Monkgogi/3rd-year-project/FINAL PROJECT.pdf

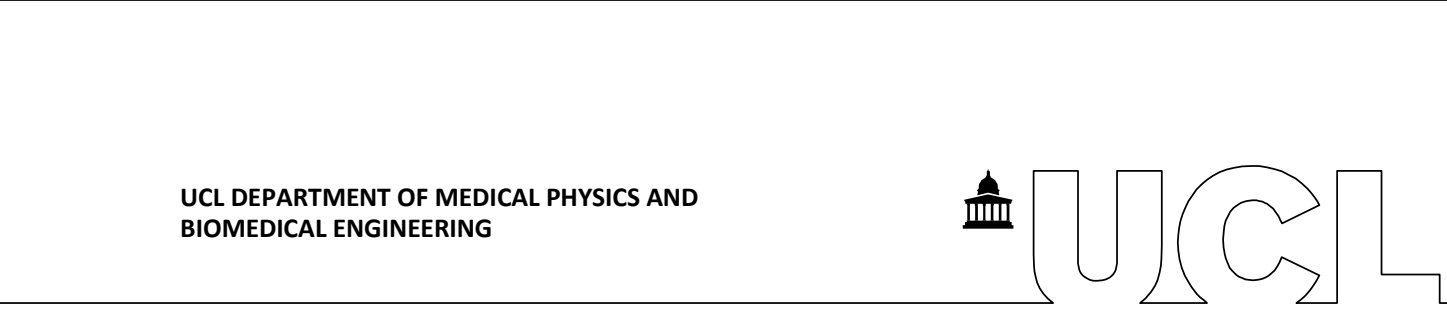
[picture p1: figure]
UCL DEPARTMENT OF MEDICAL PHYSICS AND BIOMEDICAL ENGINEERING

## Undergraduate Project Tracking Sheet

Module Code: | MPHY0042
Module Title : | Medical Physics and Biomedical Engineering Research Project
Coursework Title : | Final Report
First Supervisor | NADIPI REDDY, PRABHAV | 1 st supervisor’s e-mail | p.reddy@ucl.ac.uk
Second Supervisor | | 2 nd supervisors e-mail
Student’s Name: | Monkgogi Pako Galeitsiwe
Student’s e-mail address: | zcemmpg@ucl.ac.uk
1) Hand in a hardcopy to the main Reception Office (2nd Floor, MPEB).
Coursework Deadline: | 26 April 2021
| For Office Use Only

Date Received:

Date Returned to Student:

Before completing and submitting this piece of coursework please check that you are fully aware of the MPBE policy on plagiarism (See your Student Handbook).

Also note the penalties for late submission which can be found in the Academic Manual at the following link:

http://www.ucl.ac.uk/basc/current/assessment/latesubmission

Mark (%):

Please note that the mark is provisional and could be changed when the exam boards meet to moderate marks.
For Office Use Only
Reason for late submission of course work:

# SYSTEM FOR IN-SHOE TEMPERATURE MONITORING OF FEET

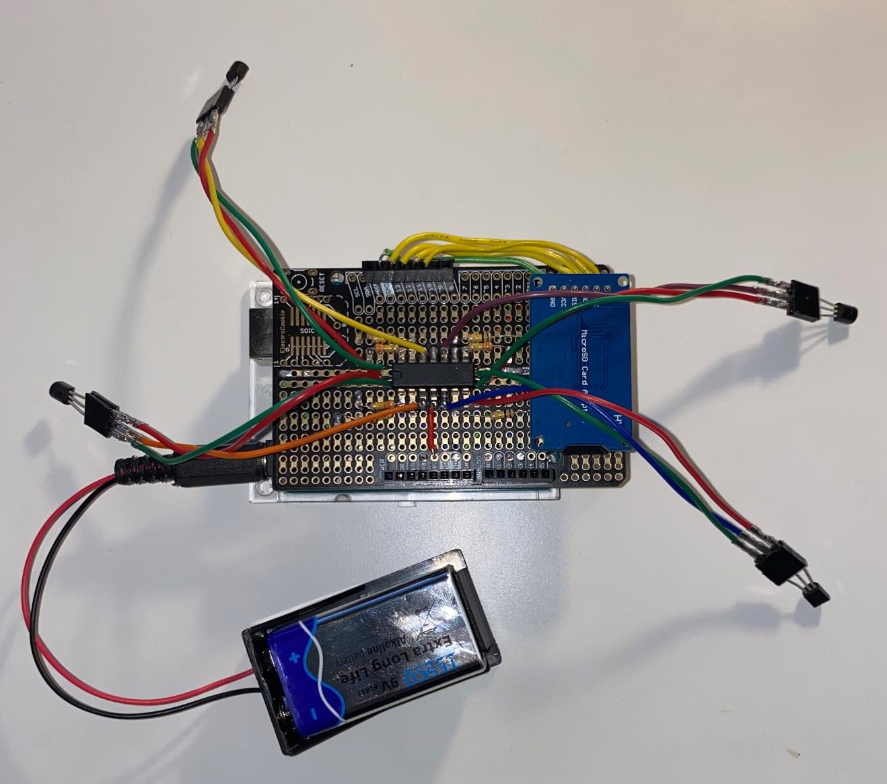
[picture p2: figure]

## TABLE OF CONTENTS

### Method | 6-11

### - Sensors - Signal conditioning - Analog to digital converter - Data storage - Battery - Sensor placement

## ABSTRACT

10% of the people that have diabetes suffer from diabetic foot ulcers. Diabetic foot ulcers are extremely difficult to treat and debilitating. They can lead to amputation and even death if not treated in time. They often lead to lengthy hospitalisation and high medical expenditure. It is important to predict the occurrence of diabetic foot ulcers before they happen. Measuring temperature is one way that can be used to predict the occurrence of diabetic foot ulcers. Studies show that areas of the feet that are more likely to get ulceration experience high temperatures compared to other parts. The aim for this project was to make an in-shoe temperature monitoring system that will be used to measure the temperature of feet. The system is compact, effective, and reliable further tests of the device is needed before it is used on patients, but the device works as intended.

## INTRODUCTION

AIM:

The aim of this project is to create an in-shoe temperature monitoring device or system that will be used to measure the temperature change of feet for people with diabetes. The system must be effective, sensitive, and compact, portable, and easy to use and inexpensive.

WHY IS IT IMPORTANT?

Diabetic patients are more likely to suffer from diabetic foot ulcers. Studies show that measuring the temperature of feet can be an effective and simple way of predicting and reducing the occurrence diabetic foot ulcers¹,2 and is an accepted method in helping preventing occurrence of diabetic foot ulcers³
. One of the most common symptoms of a disease is increased temperature at areas of inflammation⁴
. Evidence suggest that
monitoring plantar foot skin temperature at home is more effective than standard treatment procedures¹,5
, such as ambulatory activity. Trials on measuring temperature shown that areas with increased temperature were likely to develop ulcers⁶,7,8
. This could help with early prevention and reduce the incidence of diabetic foot ulcers.

In this report I will be going through how the system was designed; I how I picked the temperature sensors, the way I went through with the signal conditioning, the code I wrote for the device and the data storage and the future improvements. The system I have created is small and can fit anywhere. Results are provided to show that the device is working as intended. I will also discussion how temperature recordings will be used to predict the occurrence of the disease.

Current methods being used are either bulky, poor or must be replaced time and again and can be expensive. Sometimes the devices are not easy to use, and the patient can may find monitoring their temperature, a burden⁹
. Patients prefer a system that is easily available to use. The in-shoe temperature monitoring device is small and will be placed comfortably in sole of shoes, which makes it very easy to use. The shoe with the device can be used daily, which will decrease the chance of the patient getting ulcers¹⁰

## BACKGROUND

Diabetes affects a lot of people in the world. In 2019, roughly 463 million of adults (20-79) had diabetes and it is expected to rise 700 million cases in the world 11. It is a major cause of blindness, kidney failure, heart stroke and lower limb amputation. Its symptoms are increased thirst, frequent urination, unexplained weight loss, slow healing sores, and frequent infections such as skin infections to mention a few.

In this project, I will be focussing on the slow healing of wounds and frequent infections of the skin that happen to patients with diabetes, which will lead us to diabetic foot ulcers. Since the body cannot produce enough insulin for to convert the glucose in the blood to glycogen, this results in excess sugar in the blood. Excess sugars can injure the walls of the capillaries that nourish the neurons, especially those in the legs¹². It leaves the skin susceptible to diseases including bacterial and fungal infections¹². This is called diabetic neuropathy and diabetic nerved pain. Diabetes can lead to diabetic foot ulcers (DFU), which when not treated, they may lead the patient with diabetes have their legs amputated and we do not want that. 10 % of people with diabetes develop DFU at some point because it damages the nerves in the feet¹³ . Diabetic foot ulcers can lead to the patient dying if not treated well in time¹⁴. The mortality rates are estimated to be 5% in the first twelve months of having DFU and 42% in the 5-year mark¹⁴

To give a description of what DFU is; Diabetic foot ulcers happen when the wound on the feet takes longer to heal and can even get worse when the wound gets infected by bacteria or fungus or viruses. It happens to patients who have diabetes as said in the paragraph above and is often followed by amputation of the patient’s leg/s if not treated fast enough. It estimated that in every 30 seconds somewhere in the world, at least one limb is lost due to diabetic foot ulcers¹⁵

. It is a significant complication of diabetes mellitus¹⁶. The causes of DFU include neuropathy¹⁷, trauma, high plantar pressures

51 to mention a few and
study show that 60% of the DFU result from the causes that I mentioned¹⁸
. It often leads to
hospitalisation of the patients with diabetes and causes expensive medical expenditures if the patient has a lengthy stay in the hospital¹¹,12
. National health service(NHS) in England spends around £650 million every year on complications of diabetes¹⁹,20 and $58.6 billion is spent yearly in US to combat diabetic foot ulcers²¹,22

Diabetic foot ulcers are difficult to treat and are extremely debilitating²³. But can
DFUs be prevented? Yes, and the simpler way is for diabetic people to take care of their feet and checking with the doctor at least once a month and wearing the right shoes to reduce pressure the feet²³. Can you predict it? It is possible to predict the occurrence of diabetic foot ulcers and hence help prevent them. You can do this by measuring the temperature of the feet. Elevated temperatures can sure area of inflammation and can be an early warning sign of foot ulceration²⁴
. High temperature gradients may predict the onset of neuropathic ulceration and self-monitoring may reduce the risk of ulceration²⁵. So, I want the aim of the project is to build a circuit that will measure the temperature of the feet with high sensitivity and specificity. The system will have an efficient algorithm for early detection of the ulcers.

The proposed method of measuring temperature comprises of four sensors, which will be placed on different parts of the foot, signal conditioning circuit, analog to digital converter which is a microcontroller, the data storage section, and the power supply for the entire system. The microcontroller is Arduino Uno. It has a lot of open-source code that can be used.

## METHOD

Figure 1: schematic flowchart of proposed method

Sensors

The device I created makes use of a total of four temperature sensors. To choose the sensors, was looking at the size of the sensors, the linearity, sensitivity, and the ease to make the signal conditioning circuit and ability to be used with Arduino and the availability of the sensors in the lab.

First, I looked at the different types of temperature sensors that available. There are four types of different types of temperature sensors²⁶:

Negative temperature coefficient- (NTC) thermistors: I did the project before and I used a thermistor by then and from that project, even though are small, they require calibration and the don’t have linear sensitivity.

Resistance temperature detectors (RTDs).

Thermocouples: I could not use them because of their size alone.

Semiconductor-Based sensors: The come in different packaging styles and I looked at the sensors with TO-92 package as they are small and cost less and have a low power consumption compared to other packaging²⁷
. They have low self-heating and will not in anywhere present burning sensation to patients. The sensors also offer linear response¹¹¹ .

I choose to work with TMP36, see figure 2.

Size: the reason why I was picking a temperature sensor looking at the size, is because the sensors are to be embedded in the sole of a shoe and small sensors will not cause discomfort to the wearer of the shoes.

Tmp36 is small and has the following dimension: 4mm x 4mm x 3mm.

Sensitivity: TMP36 has a sensitivity of 10mV/°C and directly calibrated in °C which makes them much easier to work with

28

Linearity: the temperature sensor I wanted to work with had to have linear, so it is easy to get then temperature readings. TMP36 has ±0.5°C and gives 750mV at 25°C and has a temperature range of −40°C to +125°C²⁸. The linearity makes it easier to come with equation to calculate the temperature after the signal conditioning. See figure 3.

The voltage operation TMP36 is between 2.7V to 5.5V. from this, I know it can be used with Arduino as the supply voltage from is 5V. The sensor draws very small current, maximum of 50µA and this is important as the system will be powered with a battery and I want the battery to last longer.

Sensors | Signal conditioning | Analog to digital converter
Data storage

Power supply

SIGNAL CONDITIONING

As stated above the sensor’s description, the voltage output of the TMP36 at 25°C is 750mV. But I want to amplifier even the subtle voltage changes due to temperature change. The sensor doesn’t need any noise filtration. To consider the amplification, I looked at the resolution given when I measure the temperature without it:

Arduino analog to digital voltage range is 0V to 5V and there are 1024 levels at 10 bits in Arduino uno.

Voltage per division for the levels: 5
1024

= 4.88mV

And the resolution is: voltage divided by the sensor sensitivity, 10mV/°C: 4.88
10

= 0.488°C. The
resolution is low, so amplification is needed.

First, I choose the temperature range between which I wanted to amplify the voltages. Which is 15°C to 40°C. The reason for this temperature range is because feet temperatures can range from 15.6°C in the winters to 37.5°C in the summer, independent of sex and age³³ .

The temperature gives a voltage range of 650mV and 900mV and by amplifying these voltages, the resolution will increase. They amplified voltages fall between 0V and 5V.

Using this formula, VOUT = A(V⁺
-V
), where A is the gain, I calculated the max gain to be 5.556; 5V = A(0.9V). I used a non-inverting amplifier: A = 1+ R1
R2

. R1 = 330kΩ and R2 = 100kΩ giving a gain of 4.3. I choose the resistors looking at then availability and the closest I could get to the maximum gain required. To get the resolution, divide the voltage per division with the gain and the sensitivity:

4.88
4.3∗10

=0.11°C and this resolution is sufficient.

Since I have four sensors, looked for a quad op-amp and I landed on LM324AN.Quad (https://pdf1.alldatasheet.com/datasheet-pdf/view/22756/STMICROELECTRONICS/LM324AN.html) opamps have four amplifiers in one package and hence make the circuit smaller. Any quad op-amp can be used. The op-amp requires very low supply current and has power supply voltage range of ±1.5V to ±15V, which makes it easier to power with Arduino. Having a quad op-amp reduces the PCB footprint making the signal conditioning as small as possible. The circuit was tested using a myDAQ to make sure everything was working as intended. After building the amplifying circuit on a breadboard, the circuit was then soldered onto a PCB.

See figure 4 in appendices

ANALOG TO DIGITAL CONVERTER.

Arduino UNO is used as the brains of the device. It converts all the voltage readings to temperature and stores them in an SD card.

The code:

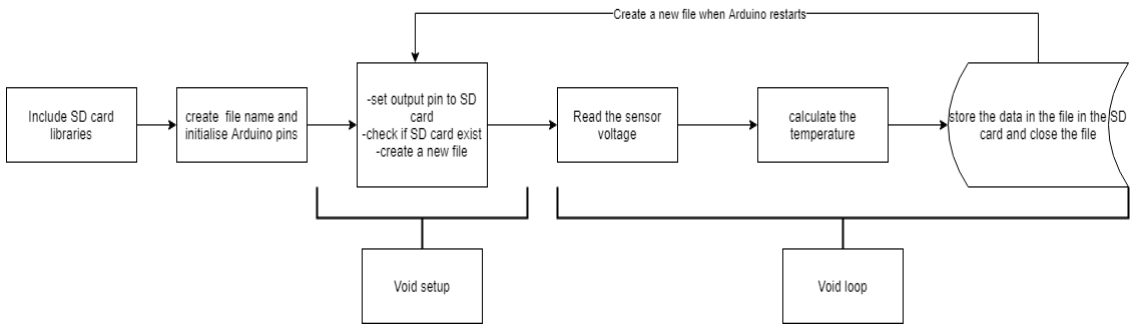
[picture p3: figure]

Figure 5 code flow diagram

Since I will be saving to an SD card, I included the SD card libraries. The SD card inserted in Arduino SD card module which is solder to the PCB with the amplifying circuit and the sensors. When picking the SD card module, I looked its ability to be used with Arduino and the one I used, requires a minimum voltage supply of 3.3V and hence can be used with Arduino. The module is also cheap and if the device is ever commercialised, it will not be expensive to make. To save the temperature to the SD card is important, because we want it to be accessible when we need to check for the temperature changes. In the SD card, the code creates a new filename each time Arduino is powered, and the temperature readings are recorded in that file. The makes sure that every time, the recording starts, the previous recording is not overwritten. The files created are csv files. This makes it easy for anyone with the data to visualise it with excel. In the future, I will add real time clock, to make sure the date and time which the data was recorded is also recorded. This will make the data tracking much easier. And I will add lines of code and a beep to alert the user to insert an SD card in case they forgot.

Sensor voltage reading: in the code I made sure that 50 readings are taken for every reading. The readings are then averaged. This makes the readings stable and reduces fluctuations in the readings. It acts as some form of filtering. The code makes use of a for loop, to avoid code repetition for averaging:

for(int i = 0; i < 50; i++) { // Average 50 readings for accurate reading

reading += analogRead(sensorA); // reading from sensor 1

reading2 += analogRead(sensorB); // reading from sensor 2

reading3 += analogRead(sensorC); // reading from sensor 3

reading4 += analogRead(sensorD); // reading from sensor 4

delay(1); // there is 1 millisecond between each of the 50 readings.

}

The voltage readings are then converted to temperature readings:

Arduino reading x 5/1023 to convert the readings to voltage.

Temperature = 1000/43 x voltage reading – 50:

The readings are taken at sampling rate of 1 temperature reading per minute. There is a delay between taking one reading and the next. As part of future aims, I will write part of the code such the code commands the device does not start recording for 10 seconds after power supply has been attached to the device. This gives the sensors time to reach the body temperature and saves space in SD card. Another part of the code runs the code for 1 hour then terminates the recording of the temperature data to the SD card and stops the coding from running by putting Arduino to sleep, until the battery reattached again. This saves power and makes the battery last longer. This will make it easier for patients to use the device without with having a burden to always check if the device is switched off to save power.

DATA STORAGE:

The device makes use of 14.5 GB SD card. After recording the data for an hour, the file size is 8KB, which is very small. It will take 1812500, which is a lot. So, we do not worry about the memory ever running out. Storing the data in microSD card makes very easier to read the data at any time, when its needed. Its convenient and cheap to replace.

BATTERY

The device makes use of 9V battery with a capacity of 1200mAh. To calculate how the battery will last, I first calculated the current drawn by each Arduino pin I used.

The input/output pins of Arduino: 40mA max

I used 4 analog pins and 4 digital pins giving a total of 320mA. This is the maximum current that all the pins can draw from the power supply. This gives a total time of battery usage of 3 hours 45 minutes.

The temperature sensors draw: 50uA X 4.

The amplifier draws a maximum current of: 375uA.

The microSD card draws a current of: 13mA when not in use²⁹

This gives a current of 13.575mA that is drawn by the whole device. And total time the battery last is 88.39779006 hours. Given that the recordings are done for only 2 hours daily, this the battery will for 44 days from the day of use.

SENSOR PLACEMENT

Diabetic foot ulcers can occur on any part of the foot, either the plantar or dorsal of the foot. Approximately half of Dfu happen on the plantar of the foot³⁰, hence the sensors of the device are on the shoe in sole, to measure the temperature of the plantar of the foot. The sensors are placed on certain areas of the insole, the feet pressure points. These are areas prone to getting ulcers over time³¹ and where foot comes in contact with the ground or the shoe insole, and this will mean good contact between the sensors and the foot.

Sensor 1: toe, Sensor 2: first metatarsal, Sensor 3: fifth metatarsal and Sensor 4: heel.

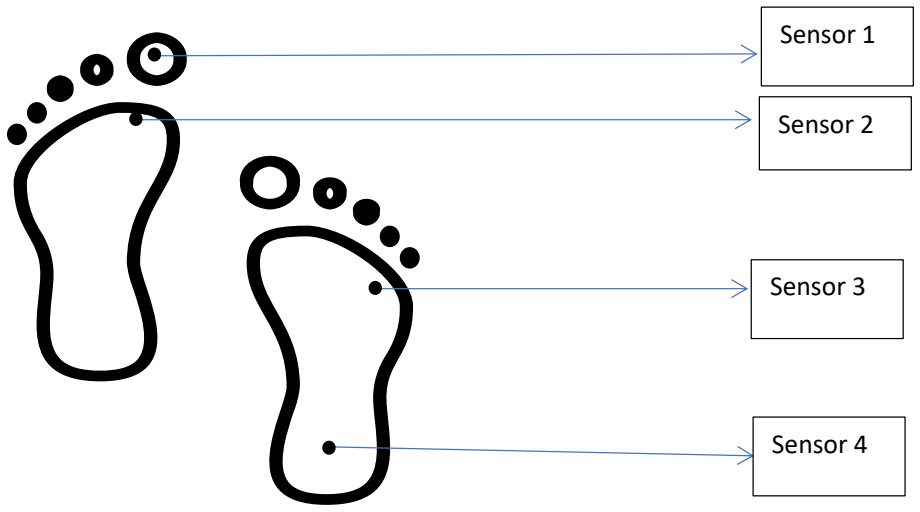
[picture p4: figure]
Sensor 1; Sensor 2; Sensor 3; Sensor 4

## RESULTS

All the temperature data is saved to the microSD card with different filenames, as said above. Figure 7 shows how the data is stored in the file. The way the files are named helps keep track of which data was recorded first. After an hour of recording, this is what the temperature data look like: figure 8 in appendices. I recorded the temperature of my room for 1 hour, at two different times of the week. The first graph, figure 9 shows sensor 4 with temperatures going to 36°C, which indicates when the wiring in the circuit is broken. The graphs show different temperature for the sensors because the sensors, when recording the temperature, have a different placement on the table and the temperature of the table influences the difference. The data is plotted in excel to see how the temperature changes over time. The second graph, figure 10, shows less fluctuations because I resoldered all the wires, creating secure connections.

Figure 6 placement of sensors

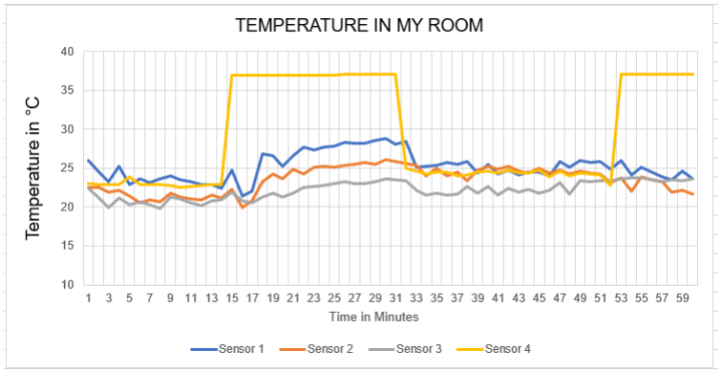
[picture p5: figure]

Figure 9 Sensor 4 shows that the wire connection in broken.

The temperature increases between the 17th minute and the 31st minute because the heater was turned on. And the shows a decrease and becomes steady after the 31st minute. The heater was turned off.

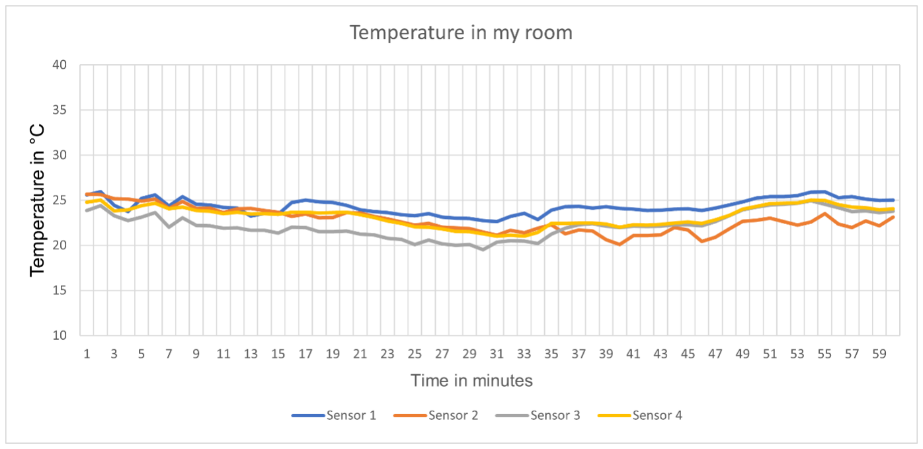
[picture p6: figure]

Figure 10

## DISCUSSION

From the results, the temperature measured in my room remains steady. The device measures temperature accurately when the temperatures are compared to the one on the thermostat. But the sometimes the temperature was lower when compared to the one on the thermostat, which can sure that, the thermostat is not really that accurate in measuring the temperature of the room.

After measuring the temperature of the feet, compare the temperatures to a reference temperature from a healthy foot . The reference temperature can be around 30.6±2.6 °C for healthy feet³², the average awake temperature of feet. A temperature difference of 2.2 °C or above between then feet, and the reference temperature, this is a sign that foot ulcers might be developing³³,34,35
, given the temperature difference stays consistently above 2.2 °C. This was shown in a study, that found that a week prior to formation of an ulcer, the areas will ulcerate had a temperature 4.8 times greater than their contralateral counterpart³⁶

An increase in temperature, indicates an inflammation and risk of ulceration, as mentioned in the introduction. One of the factors that lead to the formation of diabetic foot ulcers is, autonomic neuropathy: it causes increased peripheral blood flow and distended foot veins and warm foot³⁷. Thus, this will mean the temperature of the feet increase significantly. Studies sure that monitoring temperature can reduce the incidence of diabetic foot ulcers by 62%³⁸, also as mentioned above. In a clinical study, patients who did temperature monitoring had a significant decrease in ulceration occurrence⁴

After getting this information, early prevention methods can proceed. 50% of the patients who monitor temperature are less likely to develop ulcers⁹
. The patient can be
referred to a healthcare professional or people who are best qualified to help the patient. Further tests can be done, such as assessment of diabetic peripheral neuropathy (DPN) ³⁹ ,
to check for the presence of DPN. The test is made by determining the presence or absence of sensation in the foot. A risk assessment can then be carried out to identify the areas where the prevention strategies can be focussed. International Working Group on Diabetic foot(IWGDF) guidelines on risk assessment can be followed⁴⁰:
Category | Ulcer risk | characteristics
0 | Very low | No LOPS and No PAD
1 | low | LOPS or PAD
2 | Moderate | LOPS + PAD, or LOPS + foot deformity or PAD + foot deformity
3 | High | LOPS or PAD, and one or more of the following: • history of a foot ulcer

LOPS: Loss of protective sensation, PAD: peripheral artery disease.

Having measured an elevated temperature change, and if the patient is at category 2 or 3, different interventions for the prevention of the formation of the ulcers are used. These include regular inspection and examining the foot⁴¹

, education about the disease⁴²,43,44 , the
proper foot care

45, recommending the right footwear⁴⁶, wearing the right footwear proves to be very effective in preventing the occurrence dfus⁴⁷ and treating the risk factors. Preulcerative signs, increase in temperature in this case, can be strong indicators of the possibility of DFU happening in the future⁴⁸,53

I managed to achieve the aims of the project except, I did not manage to calculate the specificity and sensitivity, due to lack of resources, an accurate thermometer to compare the values with. In the future, I would measure temperature and compare to the ones measured by the device, so I can calculate the accuracy, sensitivity, and specificity.

During the design of the device, the wires tended to break even after soldering them. This was because the wires are too stiff, and this can be solved by using very flexible wires.

Also, to lack of resources, I did not manage to add a switch to cut the power off. I included this as part of future work.

The total cost of the device is: £36.93. This is cheap compared to other methods used to measure temperature.

## CONCLUSION

Diabetic foot ulcers can lead to amputation and even death⁴⁹
. Temperature is a good way of predicting the occurrence of diabetic foot ulcers, as studies show. I have created a device that is both reliable and sensitive to temperature change as one way that can be used to measure temperature of feet. Temperature difference of 2 °C or above ,can be a sign of inflammation and patient may need early prevention or not. Prediction can help with early prevention and treat, which saves money and time. After the prediction of the occurrence of the ulcers, further steps can be taken that will to stop the ulceration from occurring. Steps like recommending appropriate footwear, education of the disease, offloading and proper foot care. The device I made is cheap to make and easy to use, for patients and can be used to at home to measure temperature, which proves effective in predicting occurrence of DFU⁵⁰

## FUTURE WORK

- Make it wireless and create a phone application for live monitoring⁵¹
. The wireless
system will make use of Bluetooth module.
- Temperature sensors on both feet and synchronise them. That way you can compare temperatures on both feet and see which foot is more likely to develop foot ulcers.
- Make it less bulky by using a smaller size Arduino. This will make the device even more appealing and easy to place in shoes.
- Include a switch on/off button to control when the data starts being recorded. Together with a switch, include a LED light that indicates when the device started recording.
- Make it water resistant. This that, given that the patient sweats, the sweat does not cause a short circuit in the device.

## APPENDICES

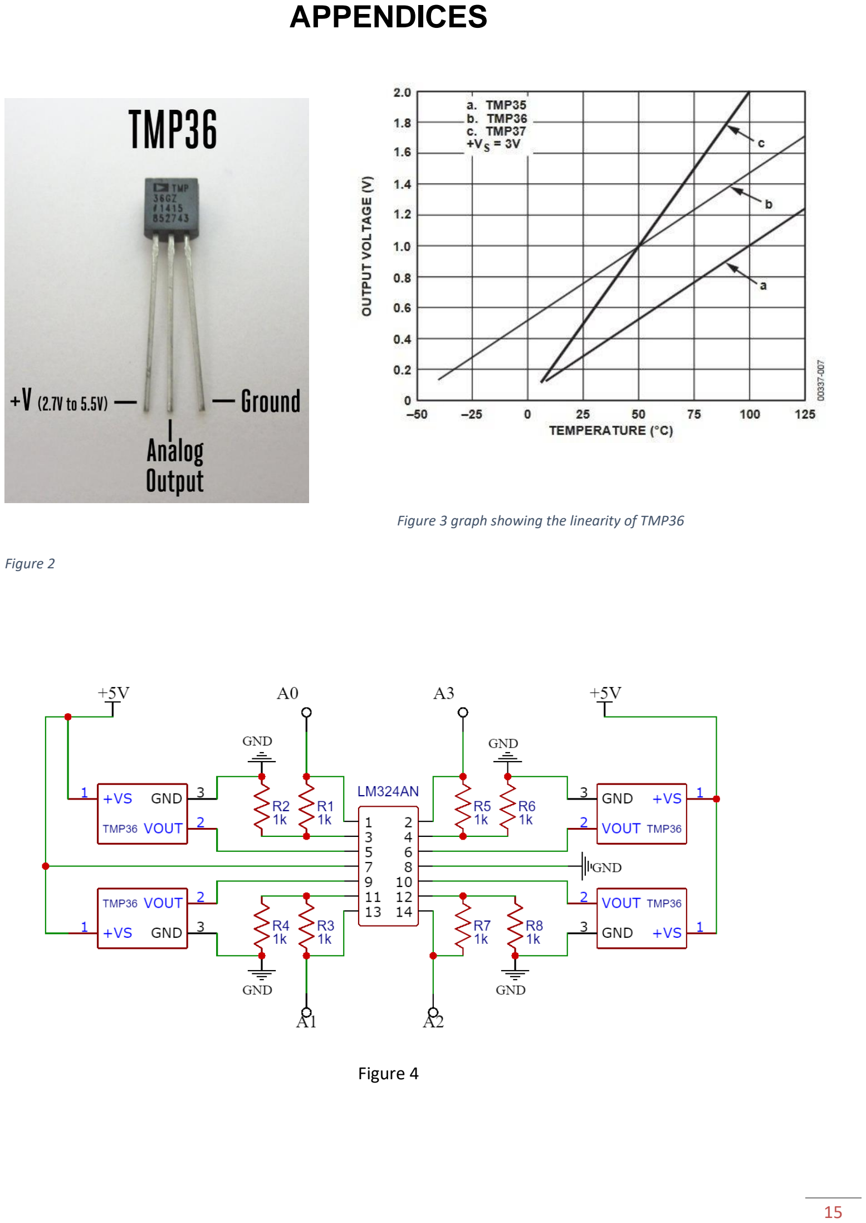
[picture p7: page 15]

Figure 4

Figure 2

Figure 3 graph showing the linearity of TMP36

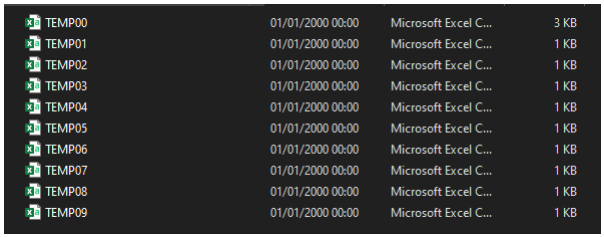
[picture p8: figure]

Figure 7 folder with different temperature data.

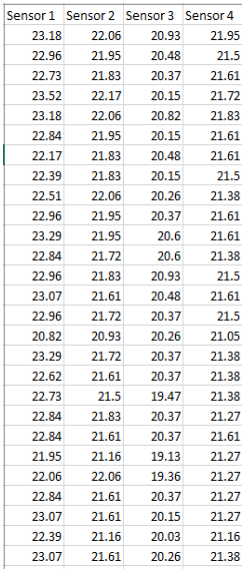
[picture p9: figure]

Figure 8

## REFERENCES

1. Armstrong DG, Lavery LA, Liswood PJ, et al. Infrared dermal thermometry of the high-risk diabetic foot. Phys Ther. 1997; 77(2):169–177.
2. Lavery LA, Higgins KR, Lanctot DR, et al. Home monitoring of foot skin temperatures to prevent ulceration. Diabetes Care. 2004 Nov; 27(11):2642-2647.
3. Bus A, van Netten JJ, Lavery LA, et al. IWGDF Guidance on the prevention of foot ulcers in at-risk patients with diabetes. Diabetes Metab Res Rev. 2016; 32(Suppl 1):16–24
4. How Temperature Monitoring Can Prevent Diabetic Foot Ulcers, December 18, 2018, Volume 31 - Issue 12 - December 2018, (https://www.podiatrytoday.com/issue/9151) Pages:12-15 By Alexander Reyzelman, DPM, and Shontal Behan Dionisopoulos, DPM
5. Bus SA. Innovations in plantar pressure and foot temperature measurements in diabetes. Diabetes Metab Res Rev. 2016 Jan;32 Suppl 1:221-6. doi: 10.1002/dmrr.2760. PMID: 26467347.
6. Lavery LA, Higgins KR, Lanctot DR, et al. Home monitoring of foot skin temperatures to prevent ulceration. Diabetes Care. 2004; 27(11):2642–2647.
7. Lavery LA, Higgins KR, Lanctot DR, et al. Preventing diabetic foot ulcer recurrence in high-risk patients: use of temperature monitoring as a self-assessment tool. Diabetes Care. 2007; 30(1):14–20.
8. Armstrong DG, Holtz-Neiderer K, Wendel C, et al. Skin temperature monitoring reduces the risk for diabetic foot ulceration in high-risk patients. Am J Med. 2007; 120(12):1042-6.
9. Lavery LA, Higgins KR, Lanctot DR, et al. Preventing diabetic foot ulcer recurrence in high-risk patients: use of temperature monitoring as a self-assessment tool. Diabetes Care. 2007 Jan;30(1):14-20
10. Foot temperature monitoring at home reduced foot complications in high risk patients with diabetes. Lavery LA, Higgins KR, Lanctot DR, et al. Home monitoring of foot skin temperatures to prevent ulceration. Diabetes Care 2004;27:2642–7.

11 diabetes, A., diabetes, W. and figures, F., 2020. International Diabetes Federation - Facts & Figures. [online] Idf.org. Available at: <https://www.idf.org/aboutdiabetes/what-isdiabetes/facts-figures.html> [Accessed 14 October 2020].

12. Mayo Clinic. 2020. Diabetes - Symptoms And Causes. [online] Available at: <https://www.mayoclinic.org/diseases-conditions/diabetes/symptoms-causes/syc-20371444> [Accessed 14 October 2020].

13 Diabetes. 2020. Closely Linked With Diabetes Neuropathy, Diabetic Nerve Pain And Diabetes Foot Care, Diabetic Foot Ulcers Affect Many People With Diabetes. Experts Suggest That Around 10 Per Cent Of People With Diabetes Develop A Foot Ulcer At Some Point. Foot Ulcers Can Affect People With Both Type 1 And Type 2 Diabetes.. [online] Available at: <https://www.diabetes.co.uk/diabetes-complications/diabetic-foot-ulcers.html> [Accessed 14 October 2020].

### 14. Everett E, Mathioudakis N. Update on management of diabetic foot ulcers. Ann N Y

Acad Sci. 2018;1411(1):153-165. doi:10.1111/nyas.13569

15. International Federation of diabetes. (2017). IDF Diabetes Altas, 8th Edition

16. Frykberg RG. Diabetic foot ulcers: pathogenesis and management. Am Fam Physician. 2002 Nov 1;66(9):1655-62. PMID: 12449264.
17. https://www.drugs.com/health-guide/foot-ulcers.html
18. Diabetic foot ulcers. Tony I. Oliver

1
; Mesut Mutluoglu

2

1 University Of South Dakota. 2 Saglik Bilimleri Universitesi

19. https://www.diabetes.org.uk/resources-s3/2017-11/diabetes%20uk%20cost%20of%20diabetes%20report.pdf (https://www.diabetes.org.uk/resources-s3/2017-11/diabetes%20uk%20cost%20of%20diabetes%20report.pdf)
20. footcare for people with diabetes, Factsheet, Available online at https://www.diabetes.org.uk/upload/News/Factsheet%20Footcare%20for%20people%20with %20diabetes.pdf, Accessed on 26 June 2015
21. Driver VR, Fabbi M, Lavery LA, Gibbons G. The costs of diabetic foot: the economic case for the limb salvage team. J Vasc Surg. 2010; 52(Suppl):17S-22S.
22. American Diabetes Association. Economic costs of diabetes in the U.S. in
2012. Diabetes Care. 2013; 36(4):1033-46.
23. Braun, Liza R et al. “Diabetic foot ulcer: an evidence-based treatment update.” American journal of clinical dermatology vol. 15,3 (2014): 267-81. doi:10.1007/s40257-014-0081-9
25. Armstrong DG, Holtz-Neiderer K, Wendel C, Mohler MJ, Kimbriel HR, Lavery LA. Skin temperature monitoring reduces the risk for diabetic foot ulceration in high-risk patients. Am J Med. 2007 Dec;120(12):1042-6. doi: 10.1016/j.amjmed.2007.06.028. Erratum in: Am J Med. 2008 Dec;121(12). doi: 10.1016/j.amjmed.2008.09.029. PMID: 18060924.

### 26. https://www.ametherm.com/blog/thermistors/temperature-sensor-types

27. https://eesemi.com/to92.htm
28. https://www.analog.com/media/en/technical-documentation/datasheets/TMP35_36_37.pdf
29. https://forum.arduino.cc/t/micro-sd-current-draw/389497

### 30. http://diabetic-foot-

salvage.com/consensus_and_guidelines_on_dfs/pathophysiology.html (http://diabetic-foot-salvage.com/consensus_and_guidelines_on_dfs/pathophysiology.html)

31. https://www.slideserve.com/adem/what-is-a-diabetic-foot-ulcer
32. Nardin RA, Fogerson PM, Nie R, Rutkove SB. Foot temperature in healthy individuals: effects of ambient temperature and age. J Am Podiatr Med Assoc. 2010 Jul-Aug;100(4):258-
64. doi: 10.7547/1000258. PMID: 20660876.
33. Armstrong DG, Lavery LA, Liswood PJ, et al. Infrared dermal thermometry of the high-risk diabetic foot. Phys Ther. 1997; 77(2):169–177.
34. Clark RP, Goff MR, Hughes J, Klenerman L. Thermography and pedobarography in the assessment of tissue damage in neuropathic and atherosclerotic feet. Thermology. 1988; 3(1):15–20.
35. Benbow SJ, Chan AW, Bowsher DR, et al. The prediction of diabetic neuropathic plantar foot ulceration by liquid-crystal contact thermography. Diabetes Care. 1994; 17(8):835-839.
36. Armstrong DG, Holtz-Neiderer K, Wendel C, et al. Skin temperature monitoring reduces the risk for diabetic foot ulceration in high-risk patients. Am J Med. 2007; 120(12):1042-6
37. Identifying and treating foot ulcers in patients with diabetes: saving feet, legs and lives (https://www.magonlinelibrary.com/doi/abs/10.12968/jowc.2018.27.Sup5.S1)

38. Beyond the Monofilament for the Insensate Diabetic Foot
Yadon Arad, Vivian Fonseca, Anne Peters, Aaron Vinik
Diabetes Care Apr 2011, 34 (4) 1041-1046; DOI: 10.2337/dc10-1666

39https://bpac.org.nz/BPJ/2014/June/diabetic-peripheral-neuropathy.aspx

40 : Bus SA, Lavery LA, MonteiroSoares M, et al. Guidelines on the prevention of foot ulcers in persons with diabetes (IWGDF 2019 update). Diabetes Metab Res Rev. 2020;36(S1):e3269. https://doi.org/10.1002/dmrr. 3269 (https://doi.org/10.1002/dmrr.%203269)

41 . Armstrong DG, Boulton AJ, Bus SA. Diabetic foot ulcers and their recurrence. N.Engl.J. Med. 2017;376:2367-2375.

42. Schaper NC, Van Netten JJ, Apelqvist J, Lipsky BA, Bakker K, International working group on the diabetic foot. Prevention and management of foot problems in diabetes: a summary guidance for daily practice 2015, based on the IWGDF guidance documents. Diabetes Metab Res Rev 2016 Jan;32 Suppl 1:7–15.
43. Price PE. Education, psychology and ‘compliance’. Diabetes Metab Res Rev. 2008 May-Jun;24(Suppl 1):S101-S105.
44. Price P. How can we improve adherence? Diabetes Metab Res Rev. 2016 Jan;32(Suppl 1):201-205
45. Schaper NC, van Netten JJ, Apelqvist J, Bus SA, Hinchliffe RJ, Lipsky BA, IWGDF Editorial Board. Practical Guidelines on the prevention and management of diabetic foot disease (IWGDF 2019 update). Diabetes Metab Res Rev. 2020;36(S1):e3266.
46. van Netten JJ, Lazzarini PA, Armstrong DG, Bus SA, Fitridge R, Harding K, et al. Diabetic foot Australia guideline on footwear for people with diabetes. J Foot Ankle Res 2018 Jan 15;11:2. doi: 10. 1186/s13047-017-0244-z. eCollection 2018.
47. Bus SA, Waaijman R, Arts M, et al. Effect of custom-made footwear on foot ulcer recurrence in diabetes: a multicenter randomized controlled trial. Diabetes Care. 2013 Dec;36(12):4109-4116.
48. Armstrong DG, Boulton AJ, Bus SA. Diabetic foot ulcers and their recurrence. N.Engl.J. Med. 2017;376:2367-2375.
49. https://theconversation.com/explainer-how-diabetic-foot-disease-can-lead-toamputations-and-even-death-66571 (https://theconversation.com/explainer-how-diabetic-foot-disease-can-lead-to-amputations-and-even-death-66571)
50. Lavery LA, Higgins KR, Lanctot DR, et al. Home monitoring of foot skin temperatures to prevent ulceration. Diabetes Care. 2004 Nov; 27(11):2642-2647.
51. Zhang YH, Han B, Pan ZP, Zhang C, Xu XL, Li XY. [Development and characteristic evaluation of wireless sensor module for wound temperature and pressure]. Zhonghua Shao Shang Za Zhi. 2020 Aug 20;36(8):671-678. Chinese. doi: 10.3760/cma.j.cn501120-20190508-00225. PMID: 32829606.
52. Frykberg RG, Lavery LA, Pham H, Harvey C, Harkless L, Veves A. Role of neuropathy and high foot pressures in diabetic foot ulceration. Diabetes Care. 1998 Oct;21(10):1714-9. doi: 10.2337/diacare.21.10.1714. PMID: 9773736.
53. Waaijman R, de Haart M, Arts ML, et al. Risk factors for plantar foot ulcer recurrence in neuropathic diabetic patients. Diabetes Care. 2014 Jun;37(6):1697-1705
